fredkri/pocket-tag-girls-night/README.md

# Pocket Tag Girls' Night
Tiny laser tag for Elab girls' night!

# Kit content:
* Bag of small parts, containing:
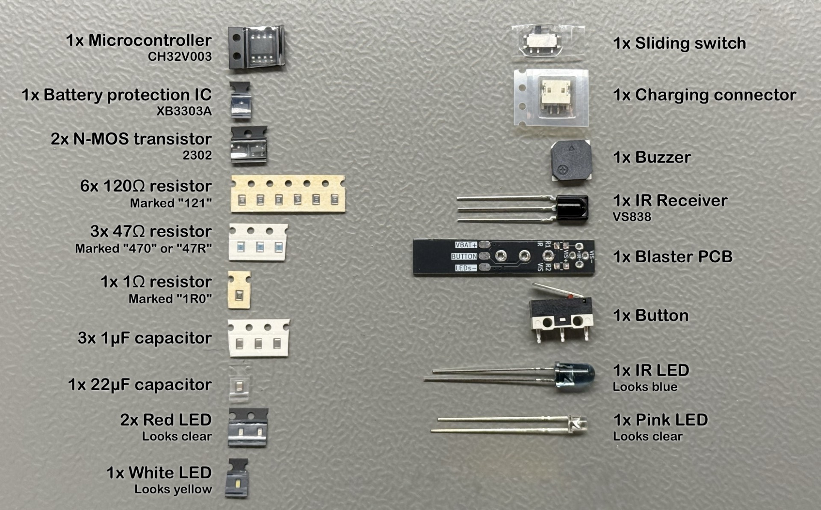
[picture p1: media/kit_content.jpg]


In addition:
* Main PCB (in red or black)
* 3d-printed laser blaster (in a variaty of colours)
* Battery
* 40cm of 3-conductor cable
* Zip tie

Optional extras:
* String to make a neck-strap
* Wire to attach neck-strap to PCB

# Assembly instructions

### 1. LED + resistor for LOGO
Components: 
- White LED for D3
- 120Ω for R5

Note the left/right direction of the LED. In addition, light should point DOWN.

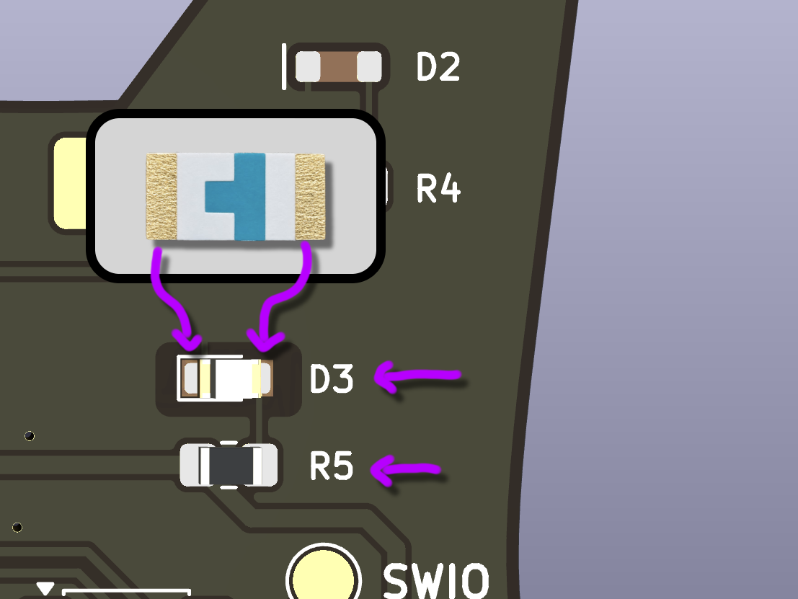
[picture p2: media/step1.png]
Step 1: solder D3, R5


### 2. LEDs + resistors for shoulder pads
Components:
- Red LEDs for D1 and D2
- 120Ω for R3 and R4

Note the left/right direction of the LEDs. In addition, light should point DOWN.

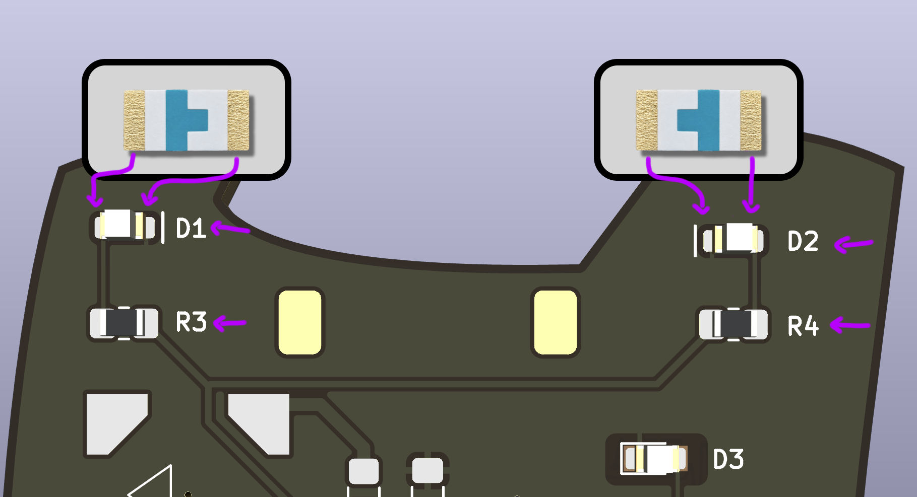
[picture p3: media/step2.png]
Step 2: solder D1, R3, D2 and R4


### Test time!

Apply 3.3V between VCC and GND on the test points. The LED under the logo should now light up.

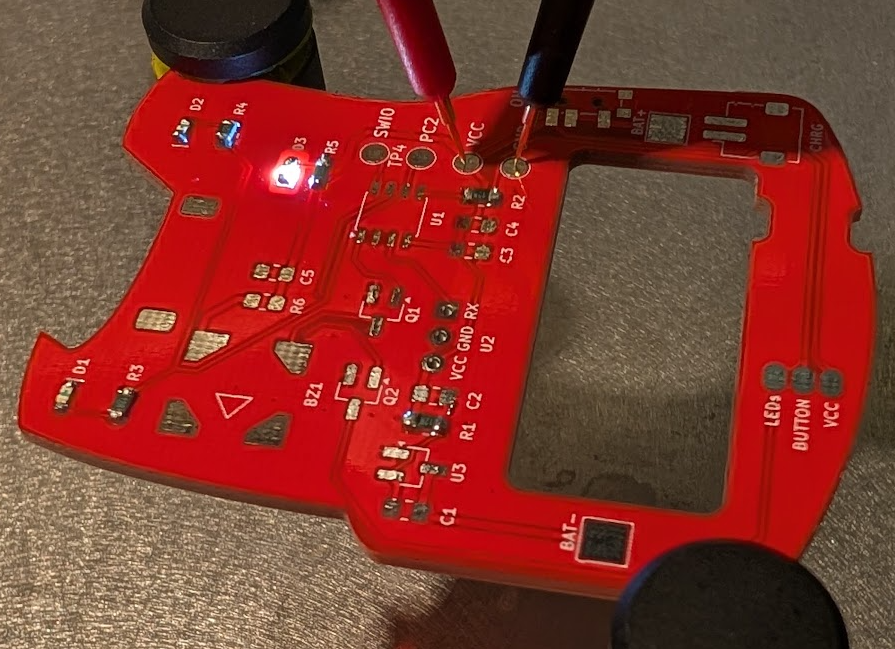
[picture p4: media/test1-logo.png]
Test logo


Apply 3.3V between PC2 and GND on the test points. The LEDs on the shoulder pads should now light up.

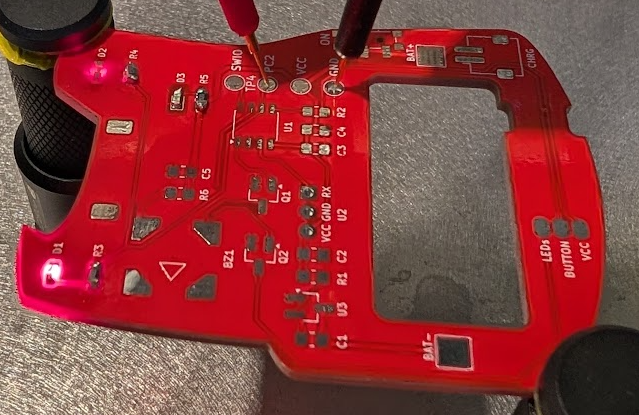
[picture p5: media/test2-shoulder-leds.png]
Test shoulder LEDs


### 3. Buzzer with components
Components:
- Buzzer for BZ1
- 2302 NMOS for Q1
- 1Ω for R6
- Skip C5

Note the direction of the buzzer. Be careful not to mistake a XB3303A battery protection IC for the 2302 MOSFET - they have the same package.

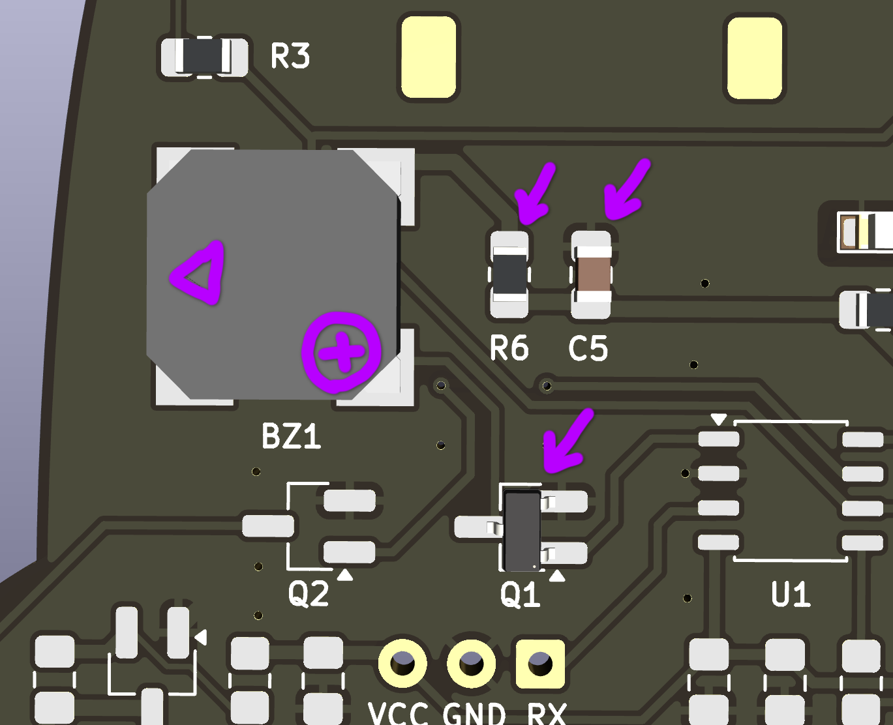
[picture p6: media/step3.png]
Step 3: solder BZ1, R6, C5 and Q1


### 4. Power and battery protection

Components: 
- 1µF for C1
- XB3303A for U3
- 120Ω for R1
- Switch for SW1
- Charging connector for CHRG

Do not confuse the XB3303A battery protection IC with the MOSFETS - they have the same package.

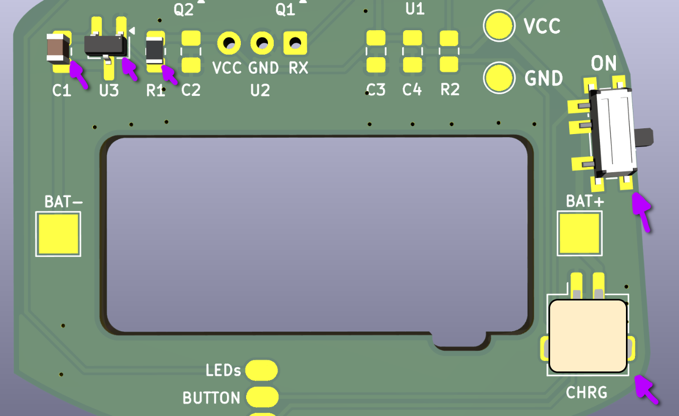
[picture p7: media/step4.png]
Step 4: solder C1, U3, R1, SW1 and CHRG


### Test time!

Apply 3.3V between BAT+ and BAT-. Turn on the power switch. The LED under the logo should turn on. Short the test points VCC and GND using tweezers or other conducting material. The LED should turn off within a second and the board should then stay off until power cycled. 

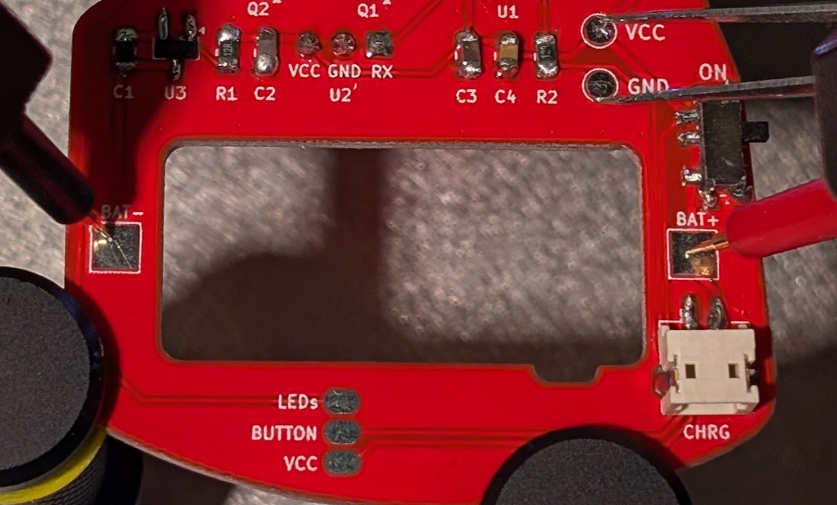
[picture p8: media/test3-battery-protection.png]
Test battery protection: short VCC and GND


### 5. Microcontroller and decoupling capacitors
Components:
- 1µF for C3
- 22µF for C4
- CH32V003 for U1

Note: Align the pin 1 marking (circle) on the microcontroller with the arrow on the PCB.

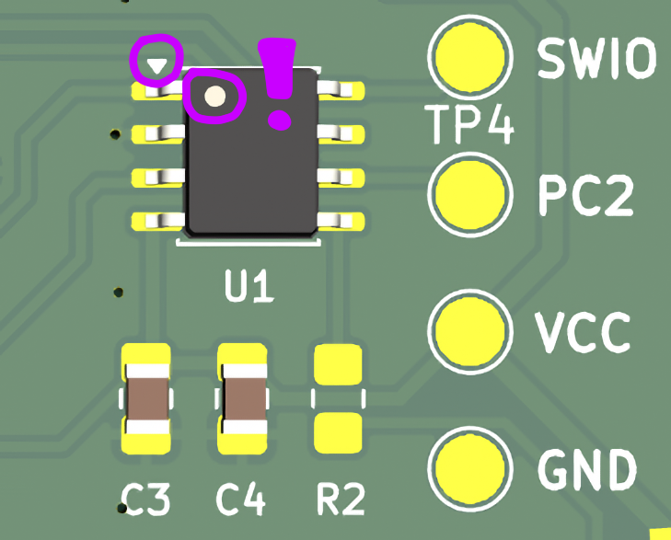
[picture p9: media/step5.png]
Step 5: solder C3, C4 and U1


### 6. Transmitter
Components:
- 2302 for Q2
- 120Ω for R2

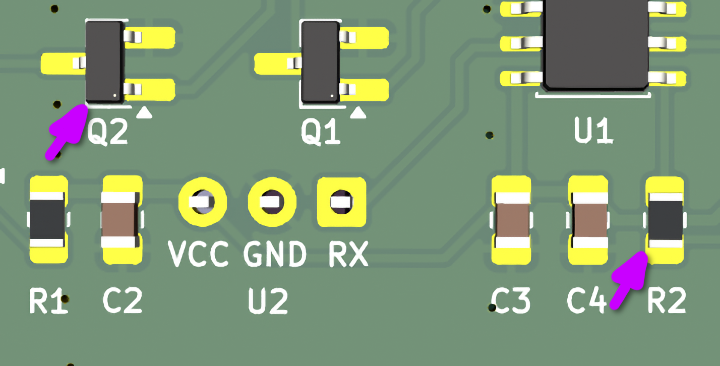
[picture p10: media/step6.png]
Step 6: solder Q2 and R2


### 7. Receiver

Components:
- 1µF for C2
- VS838 for U2

The receiver is mounted on the other side of the PCB, otherwise no one can hit you and that is cheating. Insert the legs and bend the receiver to fit in the square on the PCB before soldering. The "bump" on the receiver must face outside.

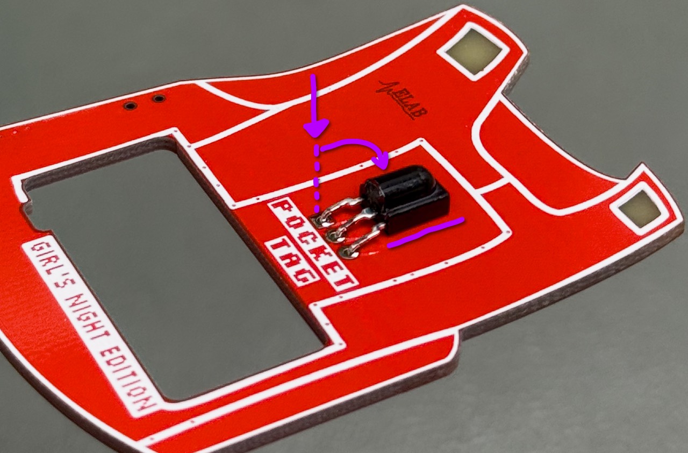
[picture p11: media/step7.jpg]
Step 7: Solder receiver


### 8. Program the microcontroller

Bring your PCB to the programming station to get your microcontroller programmed.

### 9. Battery
Solder the black side of the battery to BAT- and the red side to BAT+. 

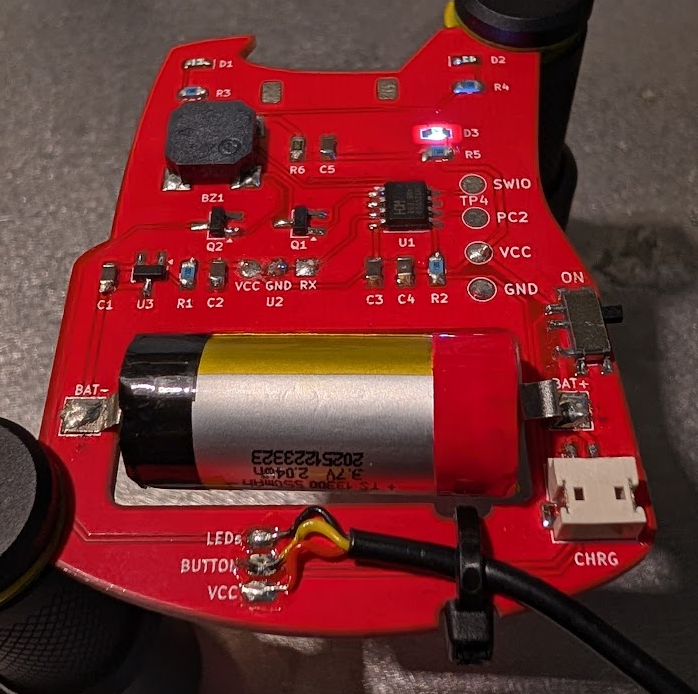
[picture p12: media/step8.png]
Step 8: solder battery and cable


# Assembly instructions - laser blaster

### 1. Resistors
Components:
- 120Ω for R1
- 47Ω for R2

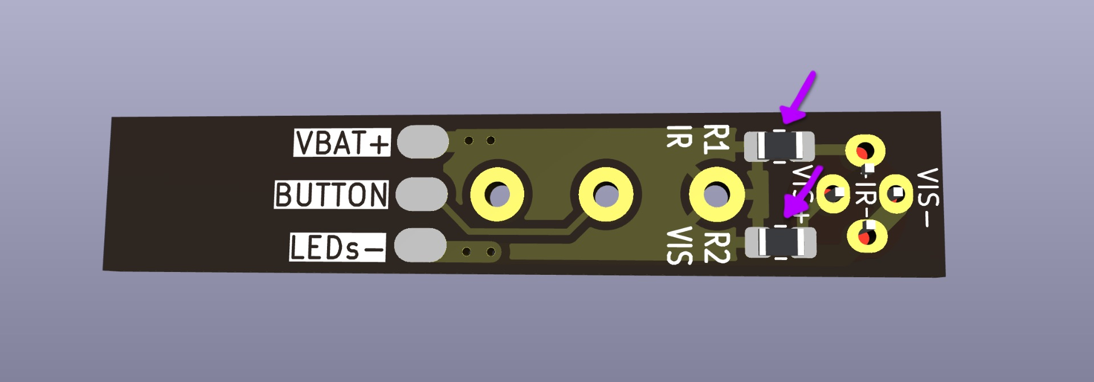
[picture p13: media/blaster-step-1.jpg]
Step 1: solder R1 and R2


### 2. Trigger switch
Components:
- SPDT 12.8x5.7mm Limit switch for SW1

From the other side of the PCB, insert the switch. Note the direction of the lever. Solder the switch.

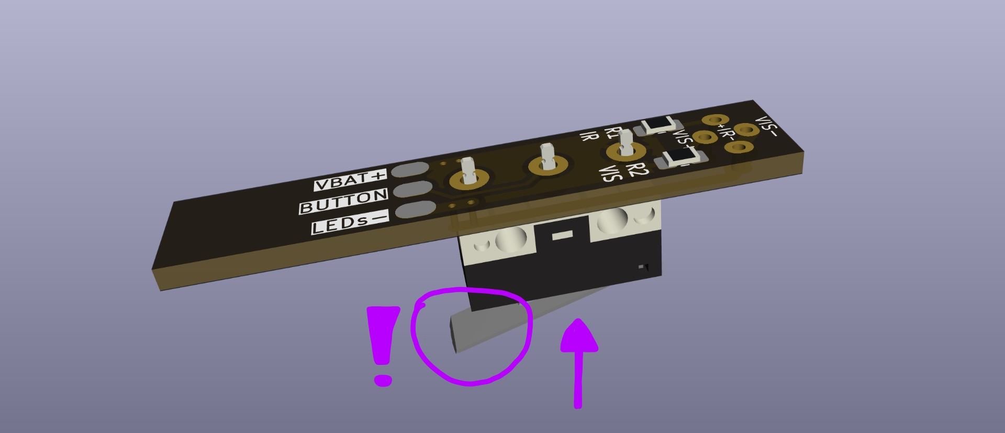
[picture p14: media/blaster-step-2.jpg]
Step 2: switch


### 3. LEDS
Components:
- TSAL6100 IR LED
- Pink THT LED

Insert the IR and Pink ("Visible") LED. You will need to bend the legs of the IR LED to fit the visible LED behind it. The longer leg of each LED should go to "+". The IR LED should be in front of the pink LED. Once both LEDs are fitted, solder all 4 of their legs. After that, cut away the extra piece of leg sticking out behind the board.

If you want your laser to blast in a different colour than pink, you can use a different visible LED.  

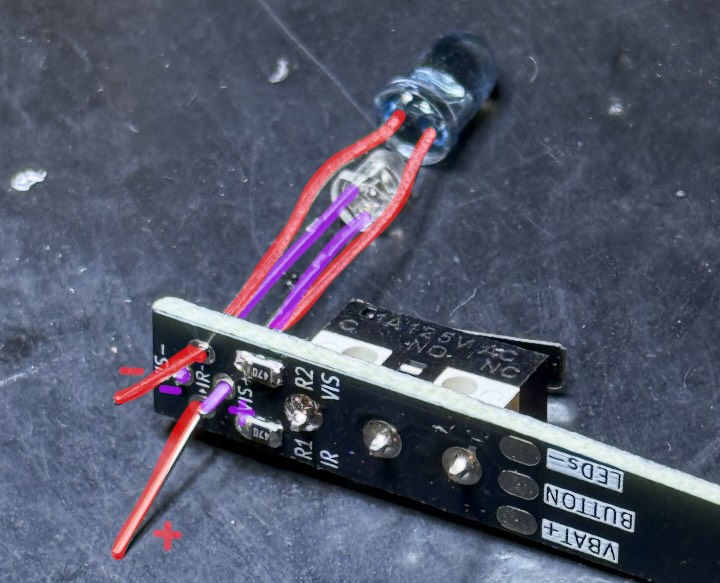
[picture p15: media/blaster-step-3.jpg]
Step 2: switch


### 4. Cable
Solder the cable to the pads
* BLACK to LEDs
* YELLOW to BUTTON
* RED to VCC

The cable should point from the pads towards the switch and LEDs (as pictured)

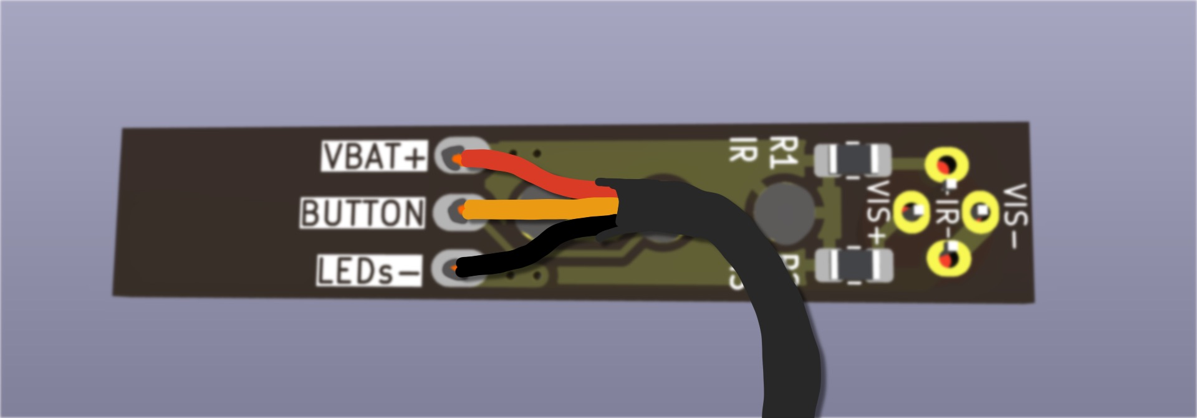
[picture p16: media/blaster-step-4.jpg]
Step 2: switch


### 5. Insert into 3d printed blaster
* Find the half of the 3d printed blaster that has the cable holding teeth (shown with arrow)
* Insert PCB into 3d print. You may need to bend the LEDs a little
* Fold the cable over and push between PCB and cable holding teeth
* Clip second half of 3d print on top

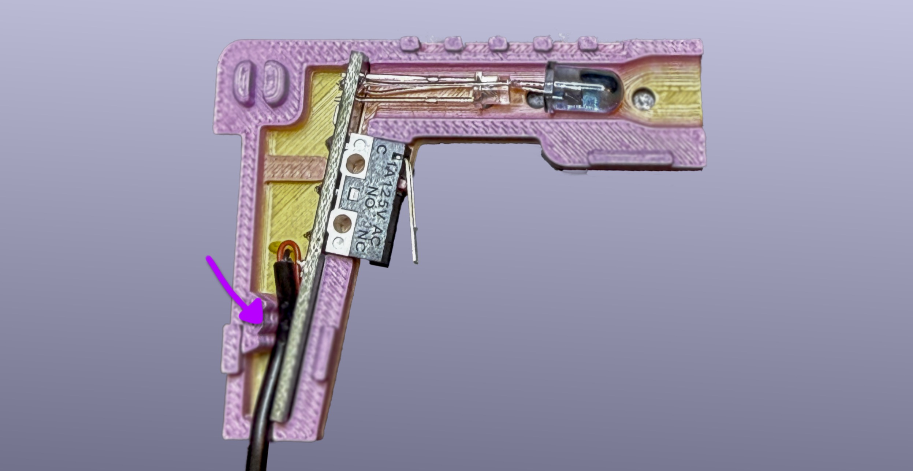
[picture p17: media/blaster-step-5.jpg]
Step 2: switch


### 6. Solder the other end of the cable to the main PCB

Solder the cable to the pads as follows:
* BLACK to LEDs
* YELLOW to BUTTON
* RED to VCC
Secure the cable with a zip tie

### Done!

You may now blast some lasers

### Optional neck strap

* Solder a thick piece of wire to the mounting points
* Attach a loop of string to the wire
