fredkri/pocket-tag-girls-night/(commit log)

2026-10-31 uploaded project files
    [LED-holder.kicad_pcb, LED-holder.kicad_sch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]
2026-10-31 assembly instructions
2026-10-31 more assembly manual
2026-11-04 more images added to assembly instruction
2026-11-04 assembly manual: arrows and new images
